GillesVanblaereHogent1/Linefollower-2024/Linefollower/Proof Of Concepts/Proof_Of_Concepts-Sensor/Elektrisch schema/Elektrisch scheme PoC Sensor.jpeg

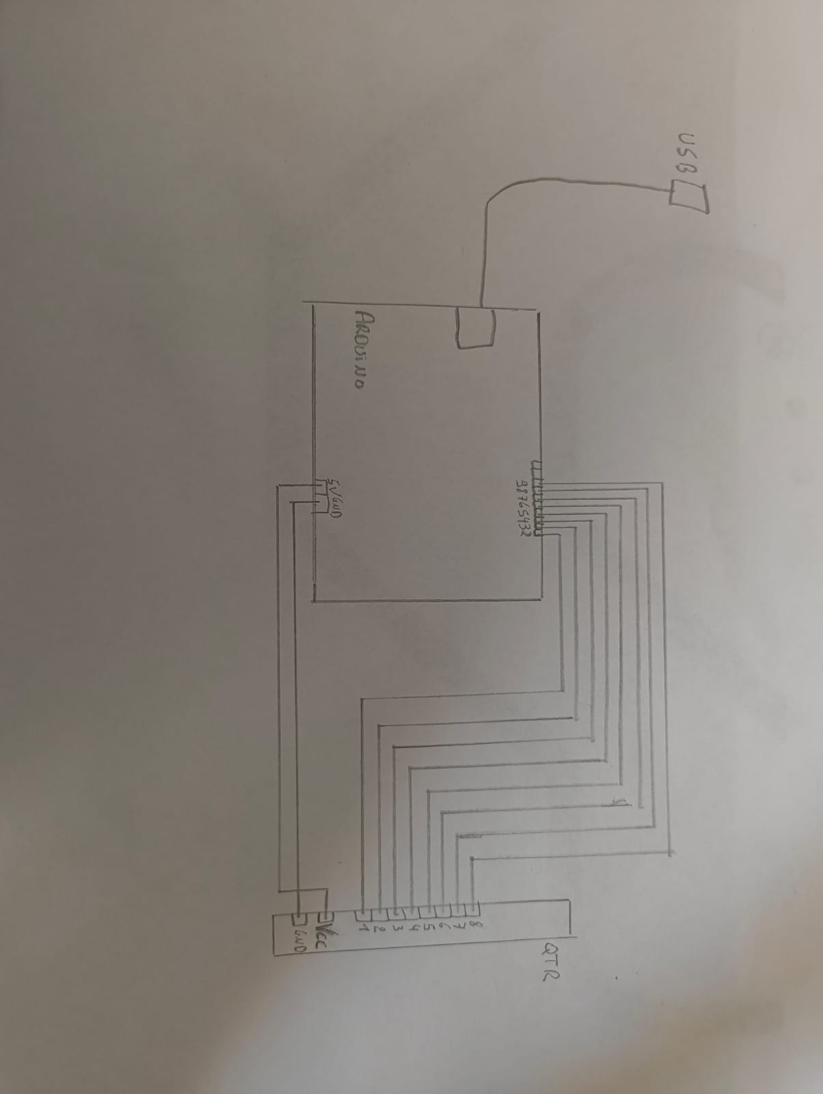
Linefollower/Proof Of Concepts/Proof_Of_Concepts-Sensor/Elektrisch schema/Elektrisch scheme PoC Sensor.jpeg
