GillesVanblaereHogent1/Linefollower-2024/Linefollower/Proof Of Concepts/Proof-Of-Concepts-H-Brug/Elektrisch schema/Elektrisch Schema- PoC-H-brug.png

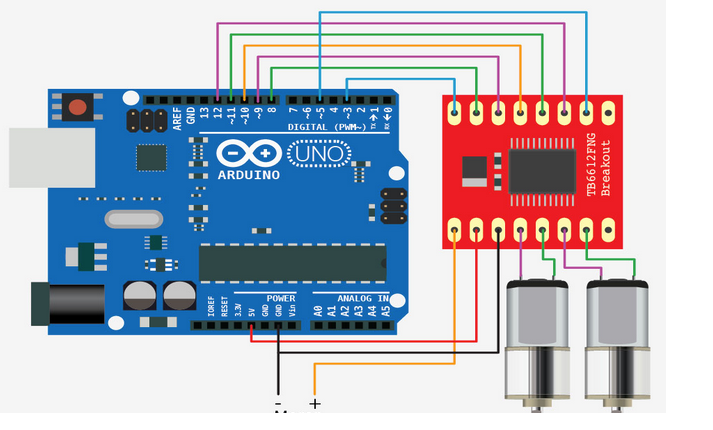
Linefollower/Proof Of Concepts/Proof-Of-Concepts-H-Brug/Elektrisch schema/Elektrisch Schema- PoC-H-brug.png
