GillesVanblaereHogent1/Linefollower-2024/Linefollower/Elektrisch Schema/Elektrisch schema.pdf

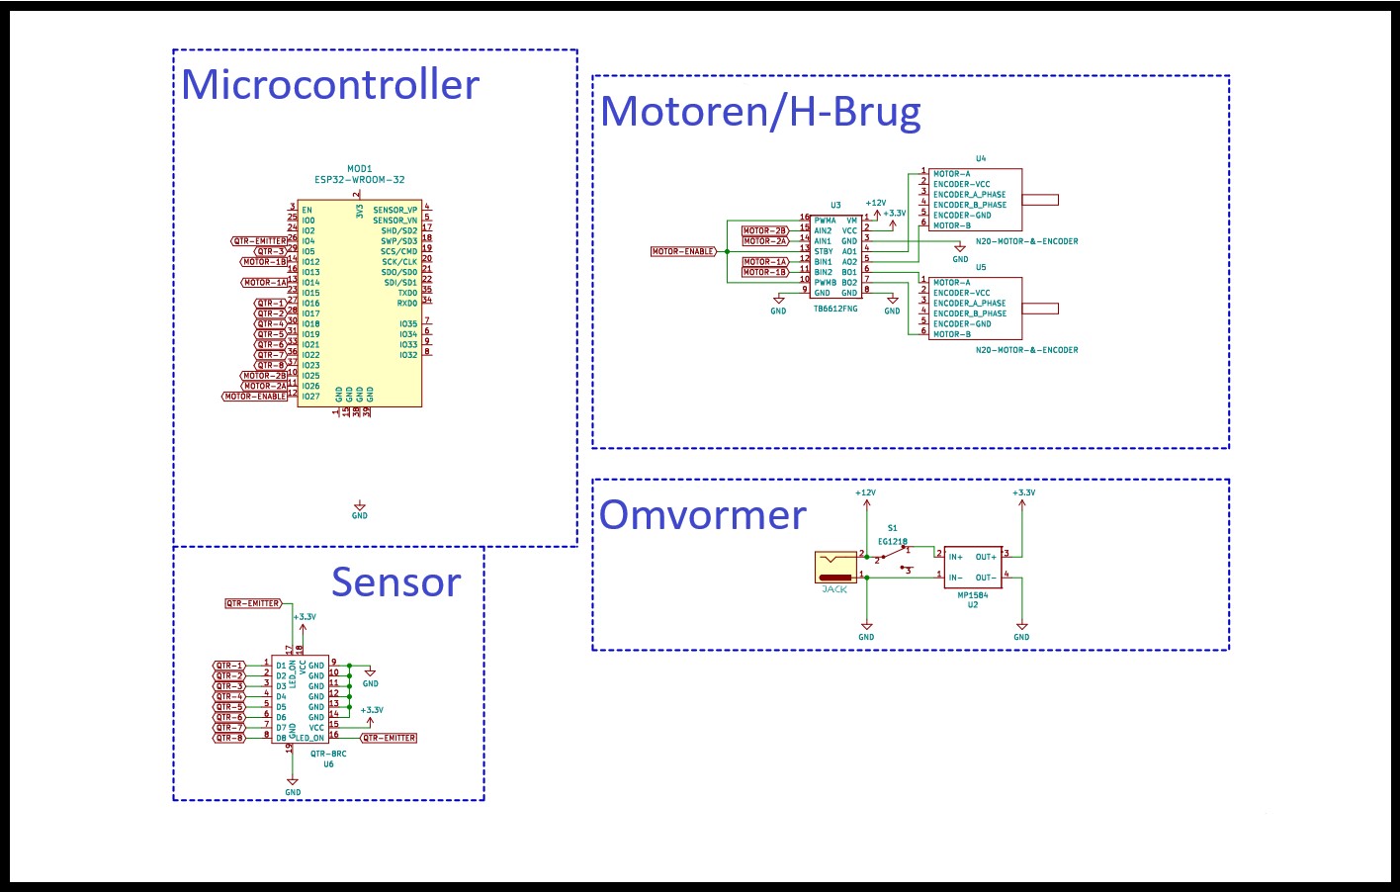
[picture p3: page 1]
