GillesVanblaereHogent1/Linefollower-2024/Linefollower/Datasheets/Batterij.png

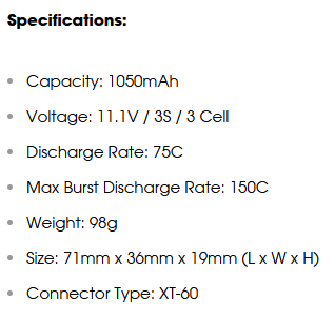
Linefollower/Datasheets/Batterij.png
