GillesVanblaereHogent1/Linefollower-2024/Linefollower/BoM/BOM- Bill Of Materials.xlsx

Naam | Materiaal | Aantal | Prijs(stuk,€ )
Printplaat | Printplaat | 1 | 0 (Thuis)
Microcontroller | NodeMCU-ESP32 | 1 | 13
batterijen | BL-4C Li-Ion Battery | 3 | 11
h burg | TB6612FNG | 1 | 6
sensoren | Pololu QTR-8RC | 1 | 9.65
Converter | MP1584 DC-DC Converter | 1 | 2.79
Motor | N20 Gear Motor 12V 300RPM | 2 | 9.78
wielen | N20 Gear 32mm | 2 | 0.68
Motor bevestiging | N20 Motor Bracket | 2 | 0.14
Wiel | Small wheel |  | 0
Schroef en bouten |  | 4 | 0
Draad | Koper draad | 6 | 2
Power Jack | DC power jack female | 1 | 0.2
Extra
batterij | Tattu LiPo-batterij 3S 1050 mAh 11,1 V | 1 | 18.99
batterij oploader | Haisito B3 Lipo oplader voor accu 2S 3S (7,4 V, 11,1 V) | 1 | 16.94
Connector | DC 5,5 x 2,5 mm adapterkabel | 1 | 9.53
