GillesVanblaereHogent1/Linefollower-2024/Linefollower/How To/Instructable.pdf

# Instructable Linefollower

## Stap 1

Koop alle onderdelen die staan in de Bill of Materials. (BoM)

## Stap 2

1. Zaag de printplaat op maat, naar gelang de grote die je zelf wil. Zorg ervoor dat alle onderdelen hierop kunnen passen.
2. Boor kleine gaatjes zodanig dat de N20 motoren en de behuizing kunnen geplaatst worden.

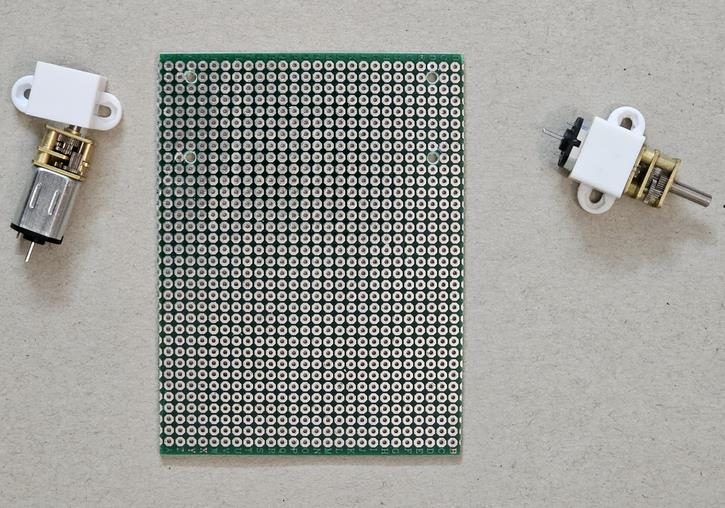
[picture p6: figure]

3. Volgende stap is het rol wiel. Hier op nieuw gaatjes boren zodanig dat deze kan geplaats worden. Deze is nodig zodat de sensor niet langs de grond schraapt.
4. Volgende stap is de sensor QTR 8RC te verbinden met de printplaat. Dit kan je doen via een pinheader te solderen aan de onderkant en voorkant van de plaat, hier zijn 11 pinnen nodig. Regel de hoogte zodanig dat de sensor 2-4mm speling heeft met de grond.
5. Hierna kan je hetzelfde doen met de esp32 dit heb ik geïnstalleerd boven de schroeven van het rijwiel zodanig dat deze niet zichtbaar zijn en dit is dicht bij de sensor zodanig er makkelijke connectie straks gelegd kan worden. Opnieuw 2 pinheaders gesoldeerd en daarop de esp32 geplaatst. Op deze esp32 zit er ook een condensator verbonden op de EN pin en de GND pin

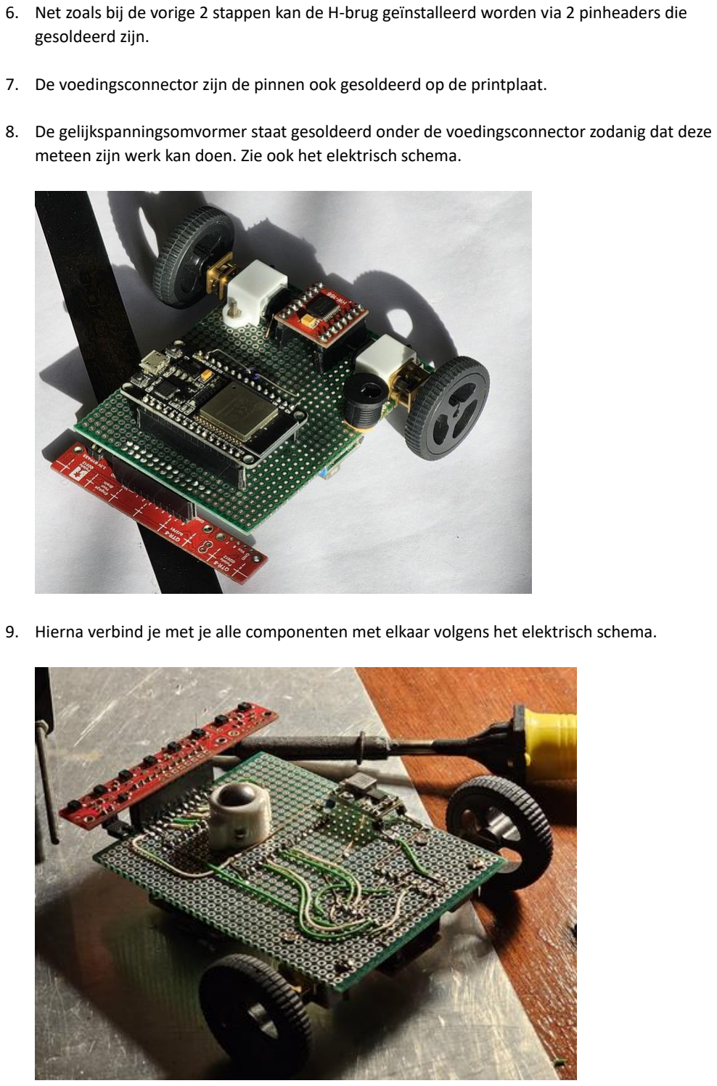
[picture p7: page 2]

6. Net zoals bij de vorige 2 stappen kan de H-brug geïnstalleerd worden via 2 pinheaders die gesoldeerd zijn.
7. De voedingsconnector zijn de pinnen ook gesoldeerd op de printplaat.
8. De gelijkspanningsomvormer staat gesoldeerd onder de voedingsconnector zodanig dat deze meteen zijn werk kan doen. Zie ook het elektrisch schema.
9. Hierna verbind je met je alle componenten met elkaar volgens het elektrisch schema.

## Stap 3

1. Om de robot te kunnen opstarten is een micro usb kabel nodig die via een computer kan verbonden worden met de esp32
2. Hiernaast is ook de voeding nodig, dit doe je via de batterij te verbinden met de voedingsconnector.
3. Als je de code in arduino opstart kan dit gecompileerd worden en geüpload worden.

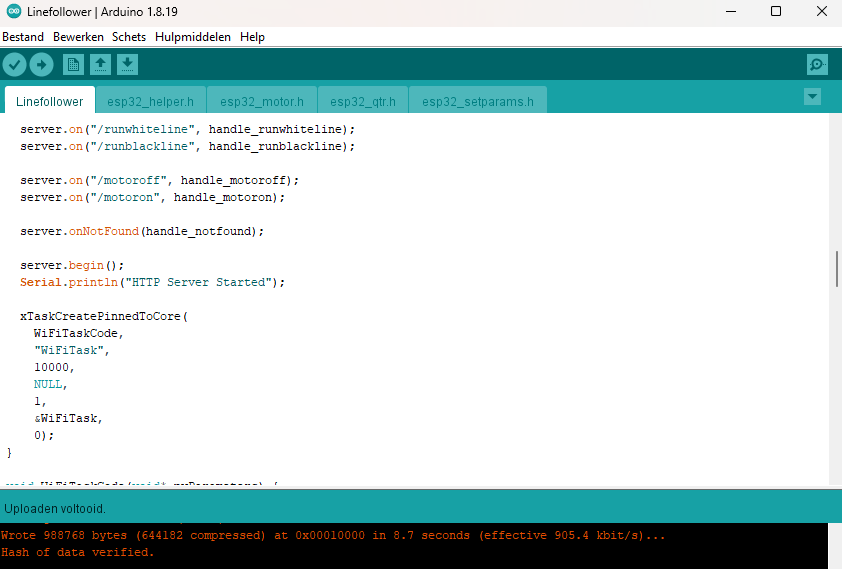
[picture p8: figure]
